russianrovercup/kosmo-platform/media/stl-previews/overview.png

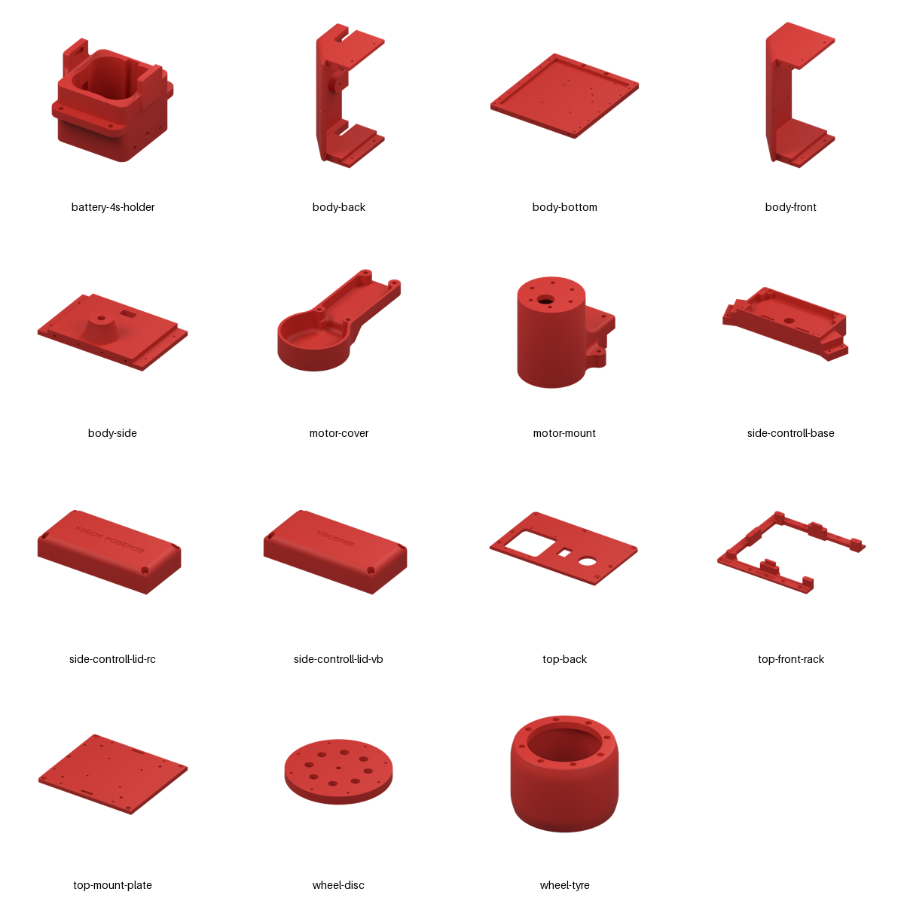
media/stl-previews/overview.png
