russianrovercup/kosmo-platform/stl/motor-cover.stl

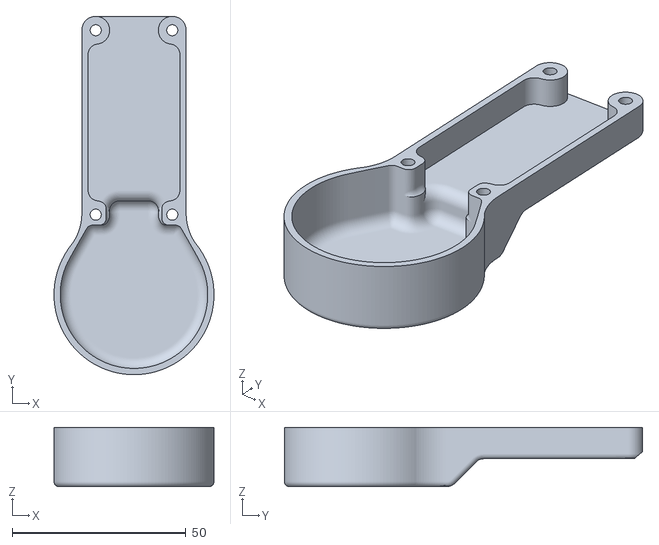
[picture p18: CAD file, 2026-10-12]
stl/motor-cover.stl
46.0 x 103.0 x 17.0
