russianrovercup/kosmo-platform/stl/body-front.stl

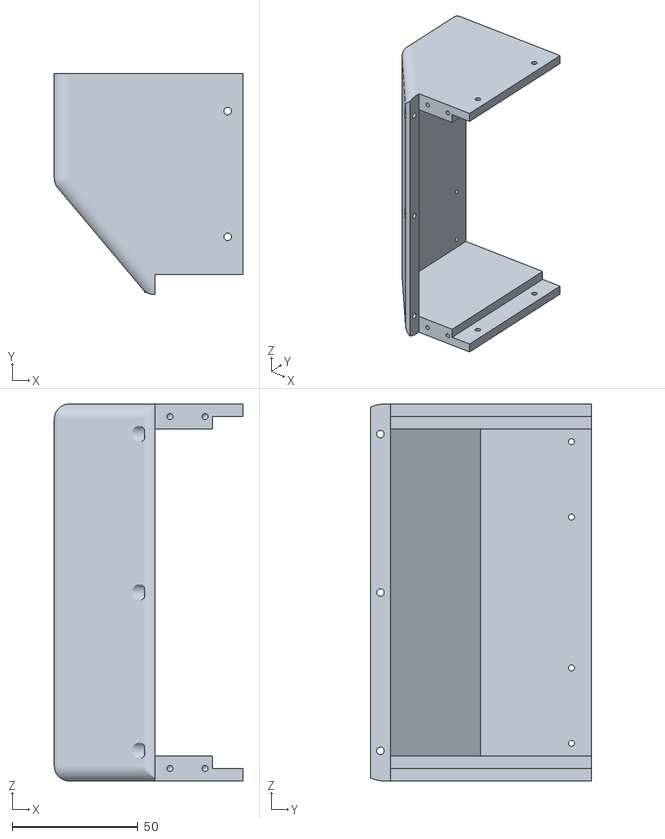
[picture p19: CAD file, 2026-10-12]
stl/body-front.stl
75.0 x 88.0 x 150.0
