russianrovercup/kosmo-platform/stl/battery-4s-holder.stl

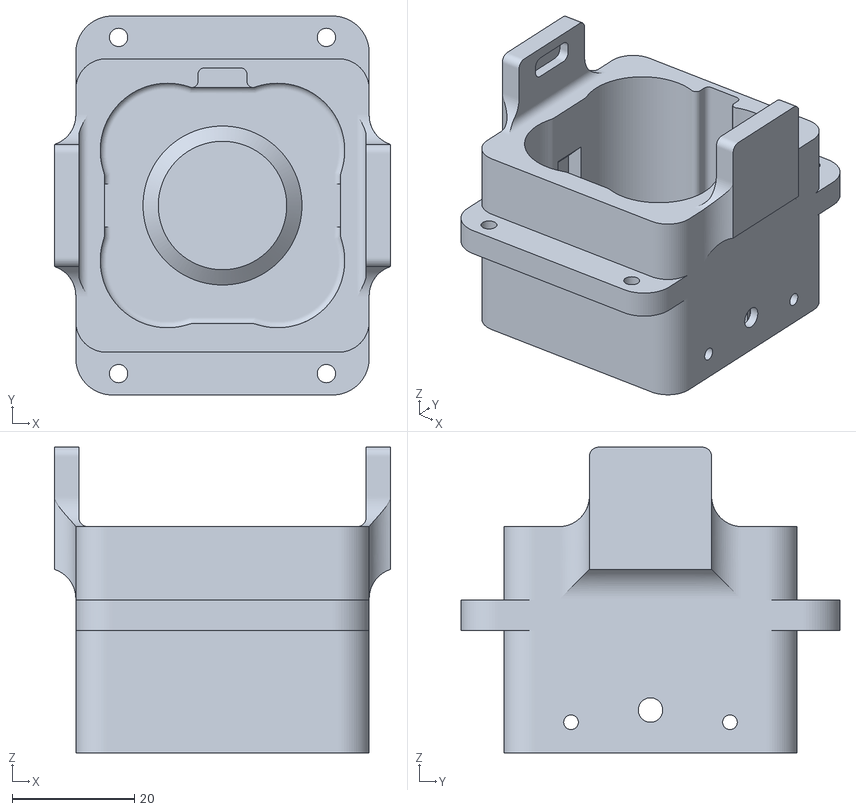
[picture p20: CAD file, 2026-10-12]
stl/battery-4s-holder.stl
55.0 x 62.0 x 50.0
