russianrovercup/kosmo-platform/stl/top-front-rack.stl

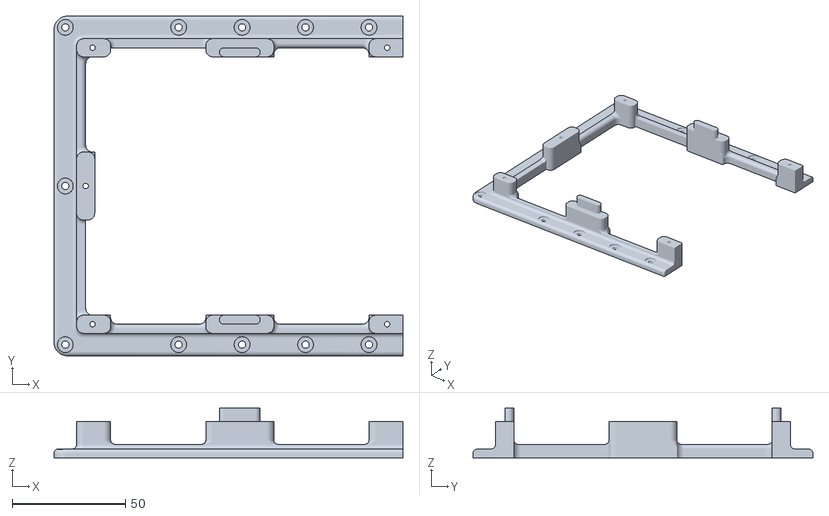
[picture p21: CAD file, 2026-10-12]
stl/top-front-rack.stl
154.0 x 150.0 x 22.0
