russianrovercup/kosmo-platform/stl/wheel-tyre.stl

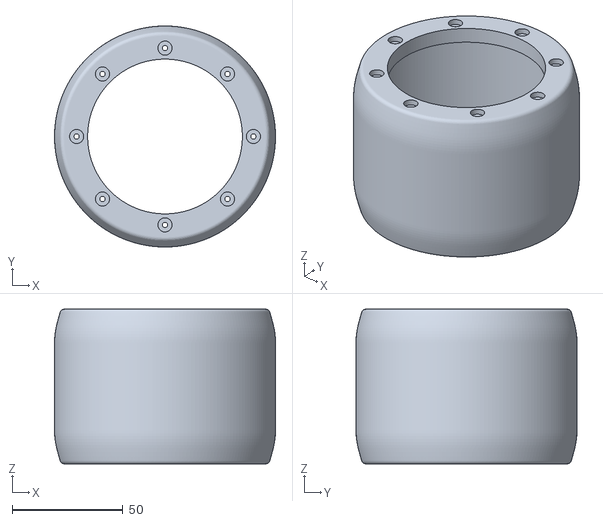
[picture p22: CAD file, 2026-10-12]
stl/wheel-tyre.stl
100.0 x 100.0 x 70.0
