russianrovercup/kosmo-platform/stl/top-mount-plate.stl

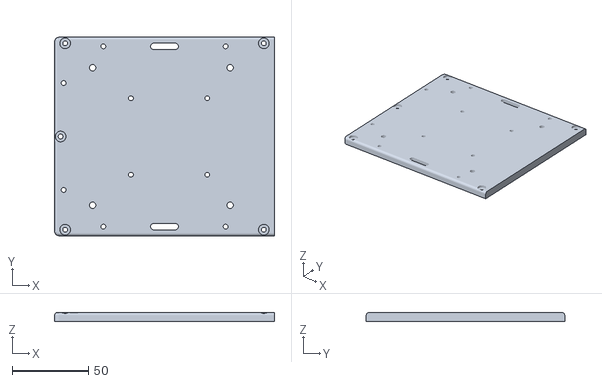
[picture p23: CAD file, 2026-10-12]
stl/top-mount-plate.stl
144.0 x 130.0 x 6.00
