russianrovercup/kosmo-platform/stl/side-controll-base.stl

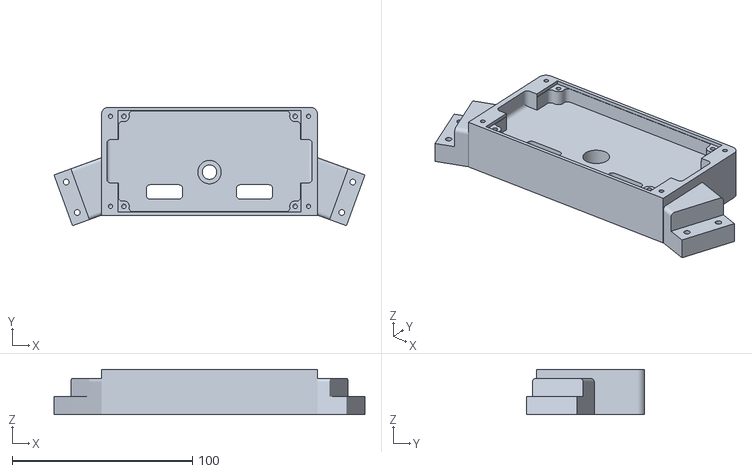
[picture p24: CAD file, 2026-10-12]
stl/side-controll-base.stl
172.6 x 65.8 x 25.0
