russianrovercup/kosmo-platform/stl/body-back.stl

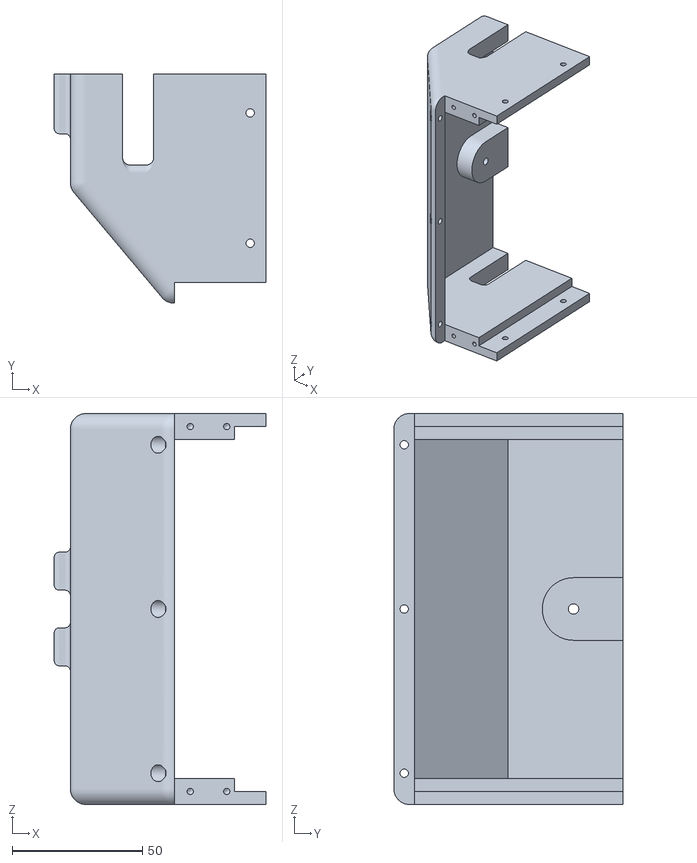
[picture p25: CAD file, 2026-10-12]
stl/body-back.stl
81.2 x 88.0 x 150.0
