russianrovercup/kosmo-platform/stl/side-controll-lid-vb.stl

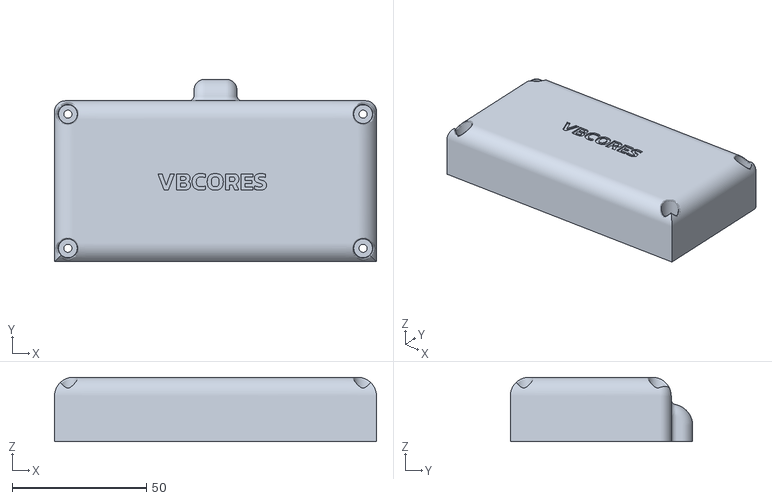
[picture p26: CAD file, 2026-10-12]
stl/side-controll-lid-vb.stl
120.0 x 68.0 x 24.0
