russianrovercup/kosmo-platform/stl/body-side.stl

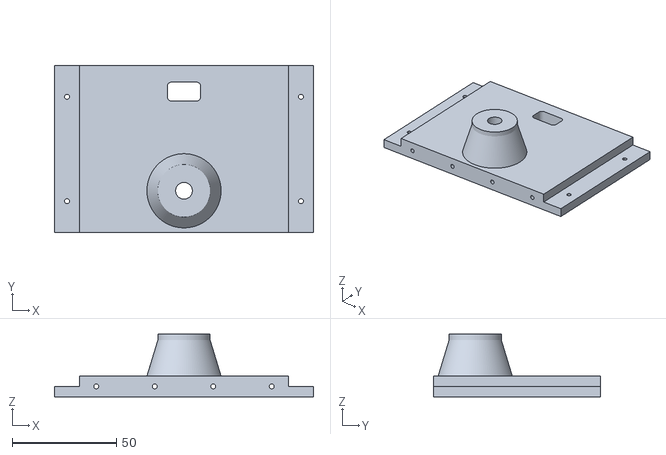
[picture p27: CAD file, 2026-10-12]
stl/body-side.stl
124.0 x 80.0 x 30.0
