russianrovercup/kosmo-platform/stl/wheel-disc.stl

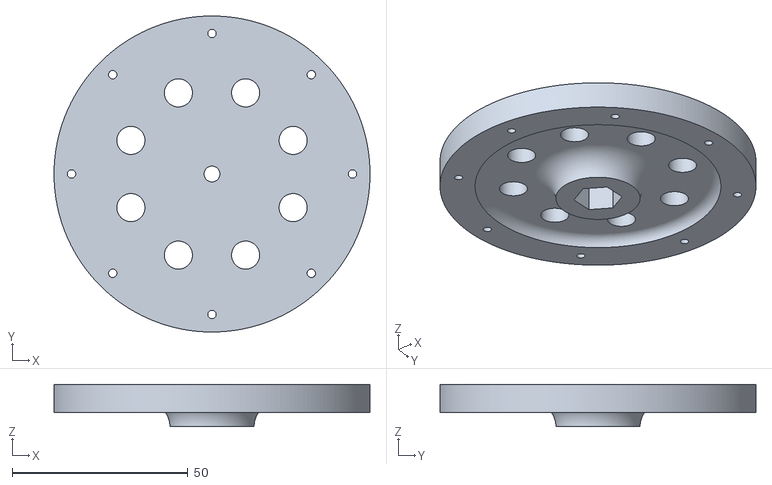
[picture p28: CAD file, 2026-10-12]
stl/wheel-disc.stl
90.0 x 90.0 x 12.0
