russianrovercup/kosmo-platform/stl/motor-mount.stl

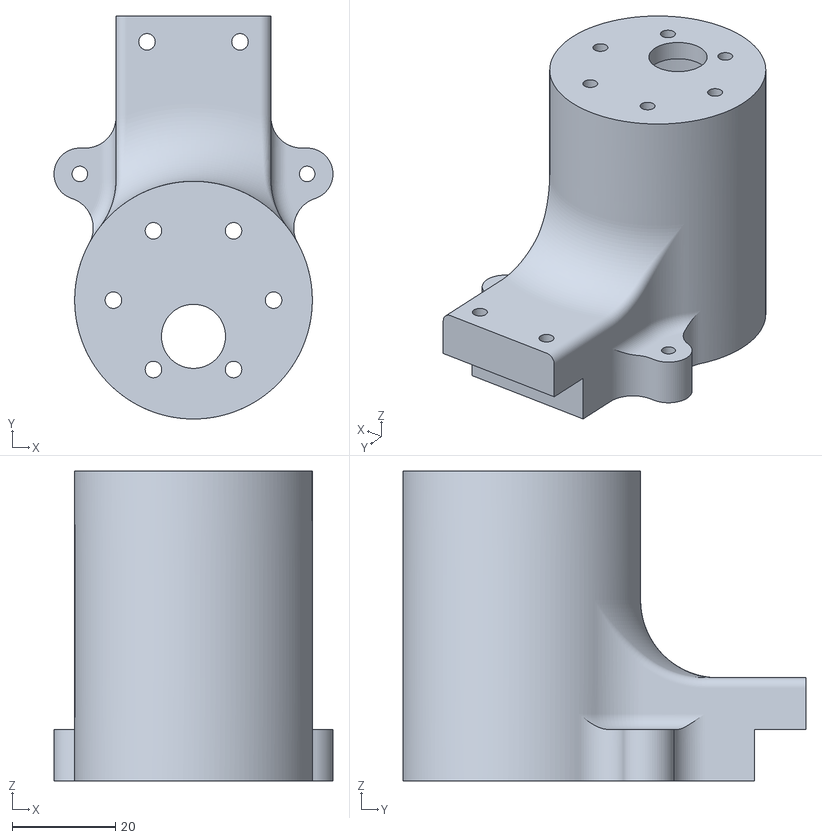
[picture p29: CAD file, 2026-10-12]
stl/motor-mount.stl
54.0 x 78.0 x 60.0
