russianrovercup/kosmo-platform/stl/body-bottom.stl

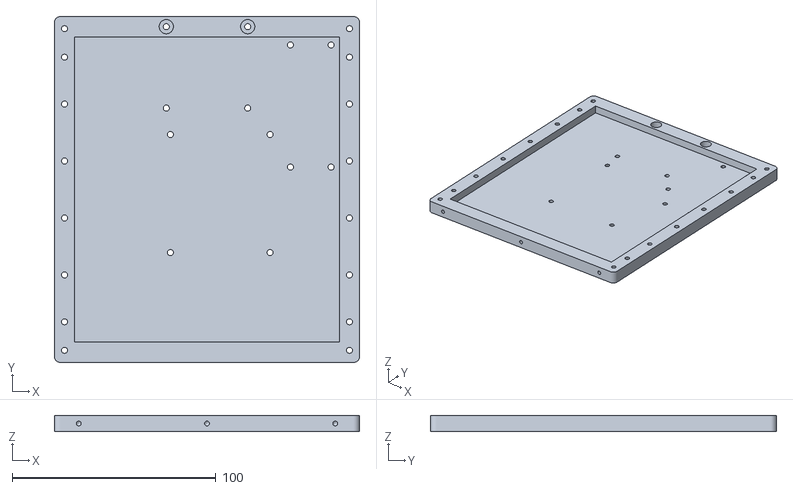
[picture p30: CAD file, 2026-10-12]
stl/body-bottom.stl
150.0 x 170.0 x 8.00
