russianrovercup/kosmo-platform/stl/top-back.stl

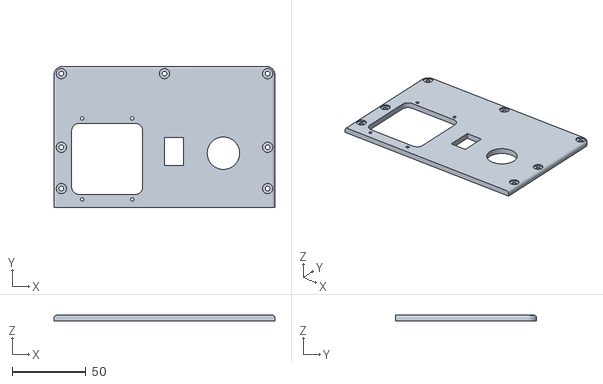
[picture p31: CAD file, 2026-10-12]
stl/top-back.stl
150.0 x 96.0 x 4.00
