russianrovercup/kosmo-platform/(list of files, cad)

Other CAD files:
stl/side-controll-lid-rc.stl
