russianrovercup/kosmo-platform/manual/README.md

# Сборка мобильной платформы КОСМО

Используйте [STEP-сборку](../step/kosmo-platform.stp) вместе с иллюстрациями для уточнения положения деталей, крепежа и проводов. Синие стрелки показывают направление установки деталей. Набор STL содержит основные детали корпуса и приводных блоков; отдельные рычаги и крепления оборудования доступны в составе STEP.

## 1. Колёсные узлы

Соберите четыре одинаковых узла. Установите мотор-редуктор в `motor-mount`, закрепите соединение диска колеса с валом и соедините `wheel-disc` с `wheel-tyre`. Положение ступицы и винтов смотрите на схеме. До установки на платформу проверьте, что колесо вращается без контакта с корпусом двигателя и крепежом.

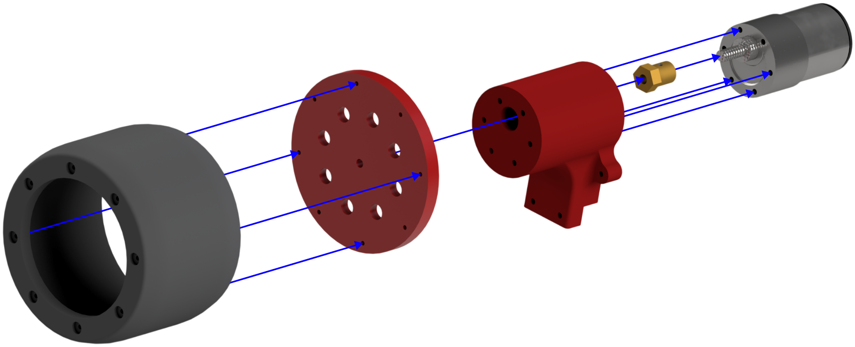
[picture p32: manual/Wheel-block_V2.png]
Сборка колёсного узла


## 2. Боковые блоки

На каждом основании `side-controll-base` закрепите по два моторных узла. Установите крышки `motor-cover`. Соберите левый и правый блоки, сверяя ориентацию с полной STEP-сборкой. Центральное отверстие основания используется для соединения с боковой стенкой корпуса.

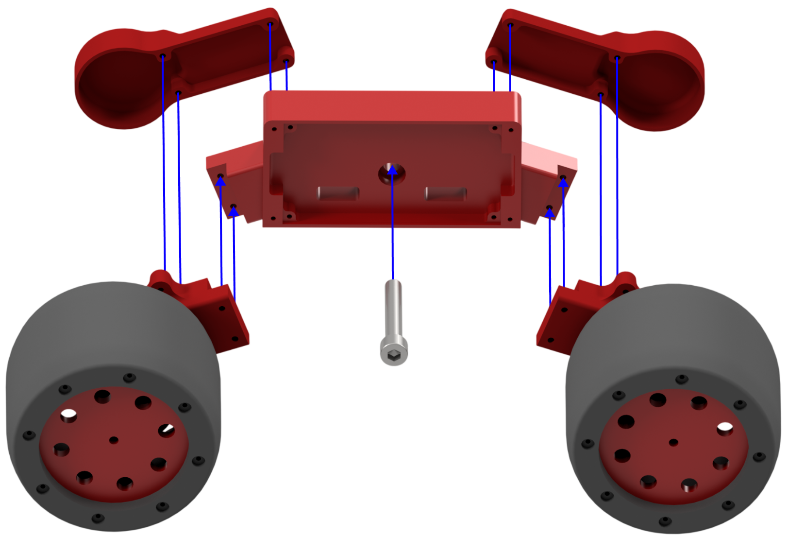
[picture p33: manual/side-block_2.png]
Сборка бокового блока


## 3. Корпус и рычажный механизм

Соберите рычажный узел на задней стенке по отдельной схеме. Подвижное соединение должно сохранять свободный ход после затяжки крепежа.

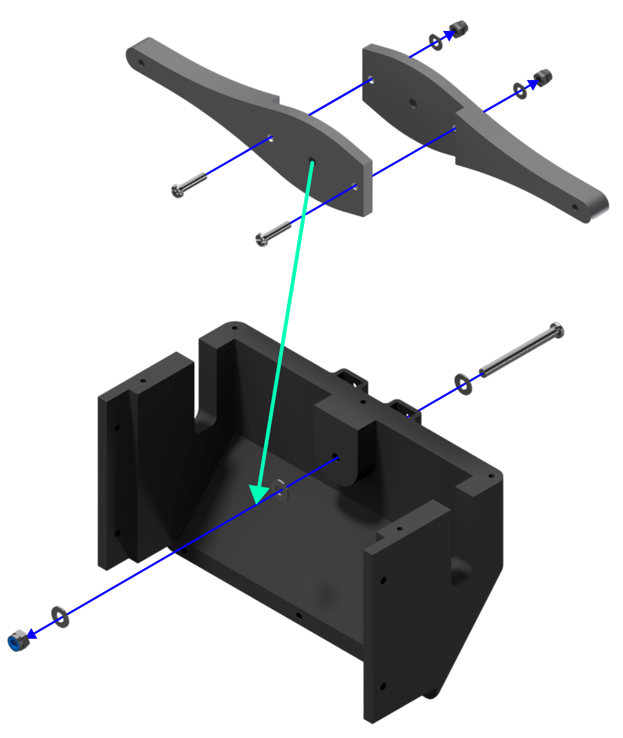
[picture p34: manual/suspension_1.png]
Сборка рычажного механизма


Соедините `body-bottom` с передней и задней стенками, затем установите две `body-side`. Установите заднюю верхнюю панель и предусмотренные выбранной комплектацией держатели, выключатель и кнопку. Точные размеры крепежа и элементы, не представленные отдельными STL, уточняйте в STEP.

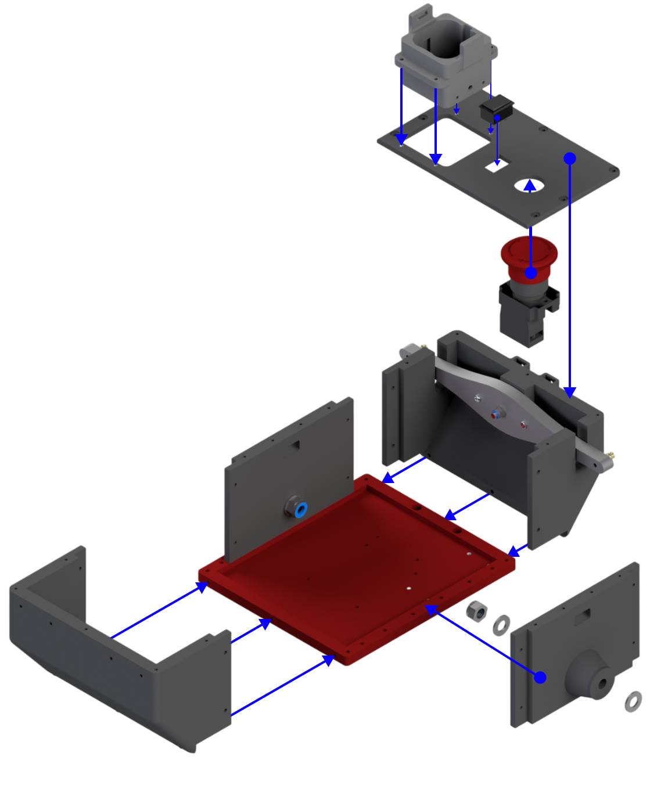
[picture p35: manual/box-block.png]
Сборка центрального корпуса


Присоедините боковые блоки к корпусу и соедините рычажный механизм с ними, как показано в STEP и на следующей иллюстрации. Проверьте свободный ход боковых блоков и отсутствие контакта шин с корпусом.

## 4. Электроника бокового блока

Установите плату на предусмотренные крепления, проложите провода и закройте блок крышкой `side-controll-lid-rc` или `side-controll-lid-vb`. Выбор крышки зависит от исполнения. На схеме показано механическое размещение платы, а не схема подключения.

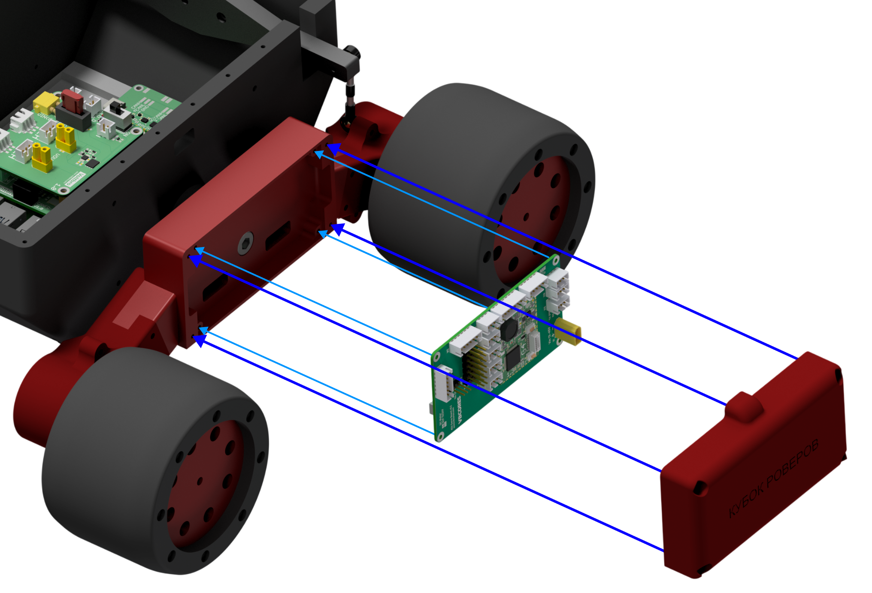
[picture p36: manual/Kosmo-platform_side_electronic.png]
Размещение электроники в боковом блоке


Провода должны иметь запас длины для движения подвески и не попадать в колёса и шарниры. Проверьте это во всём механическом диапазоне до закрытия крышек.

## 5. Верхняя рамка и монтажная площадка

Закрепите аккумулятор в держателе и установите электронику центрального корпуса. Затем закрепите `top-front-rack` и `top-mount-plate`..

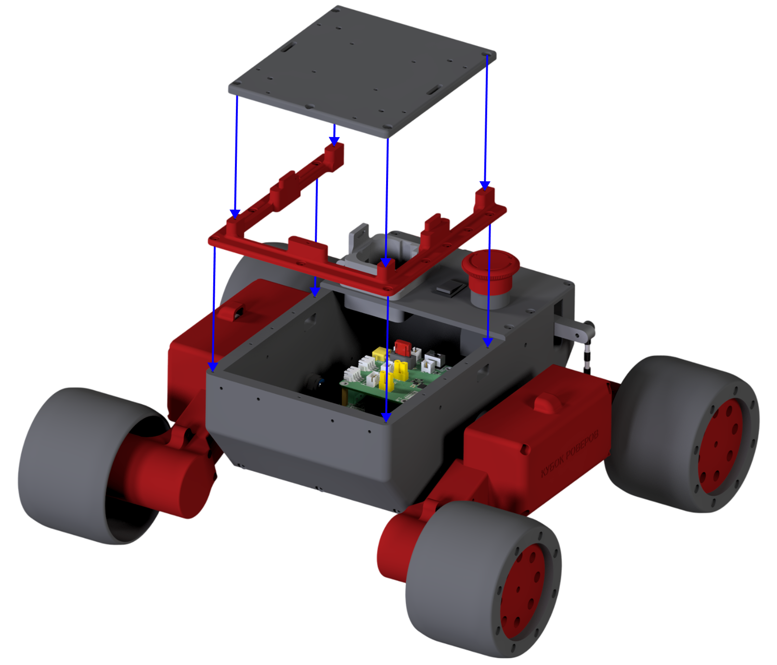
[picture p37: manual/kosmo-platform_last-step.png]
Установка верхней рамки и монтажной площадки


[← Вернуться к описанию проекта](../README.md)
